cmu-spacecraft-design-build-fly-2023/Avionics-PyCubed-hardware/mainboard-v05/Avionics.kicad_sch

## KiCad design mainboard-v05/Avionics.kicad_sch (2023-09-07)

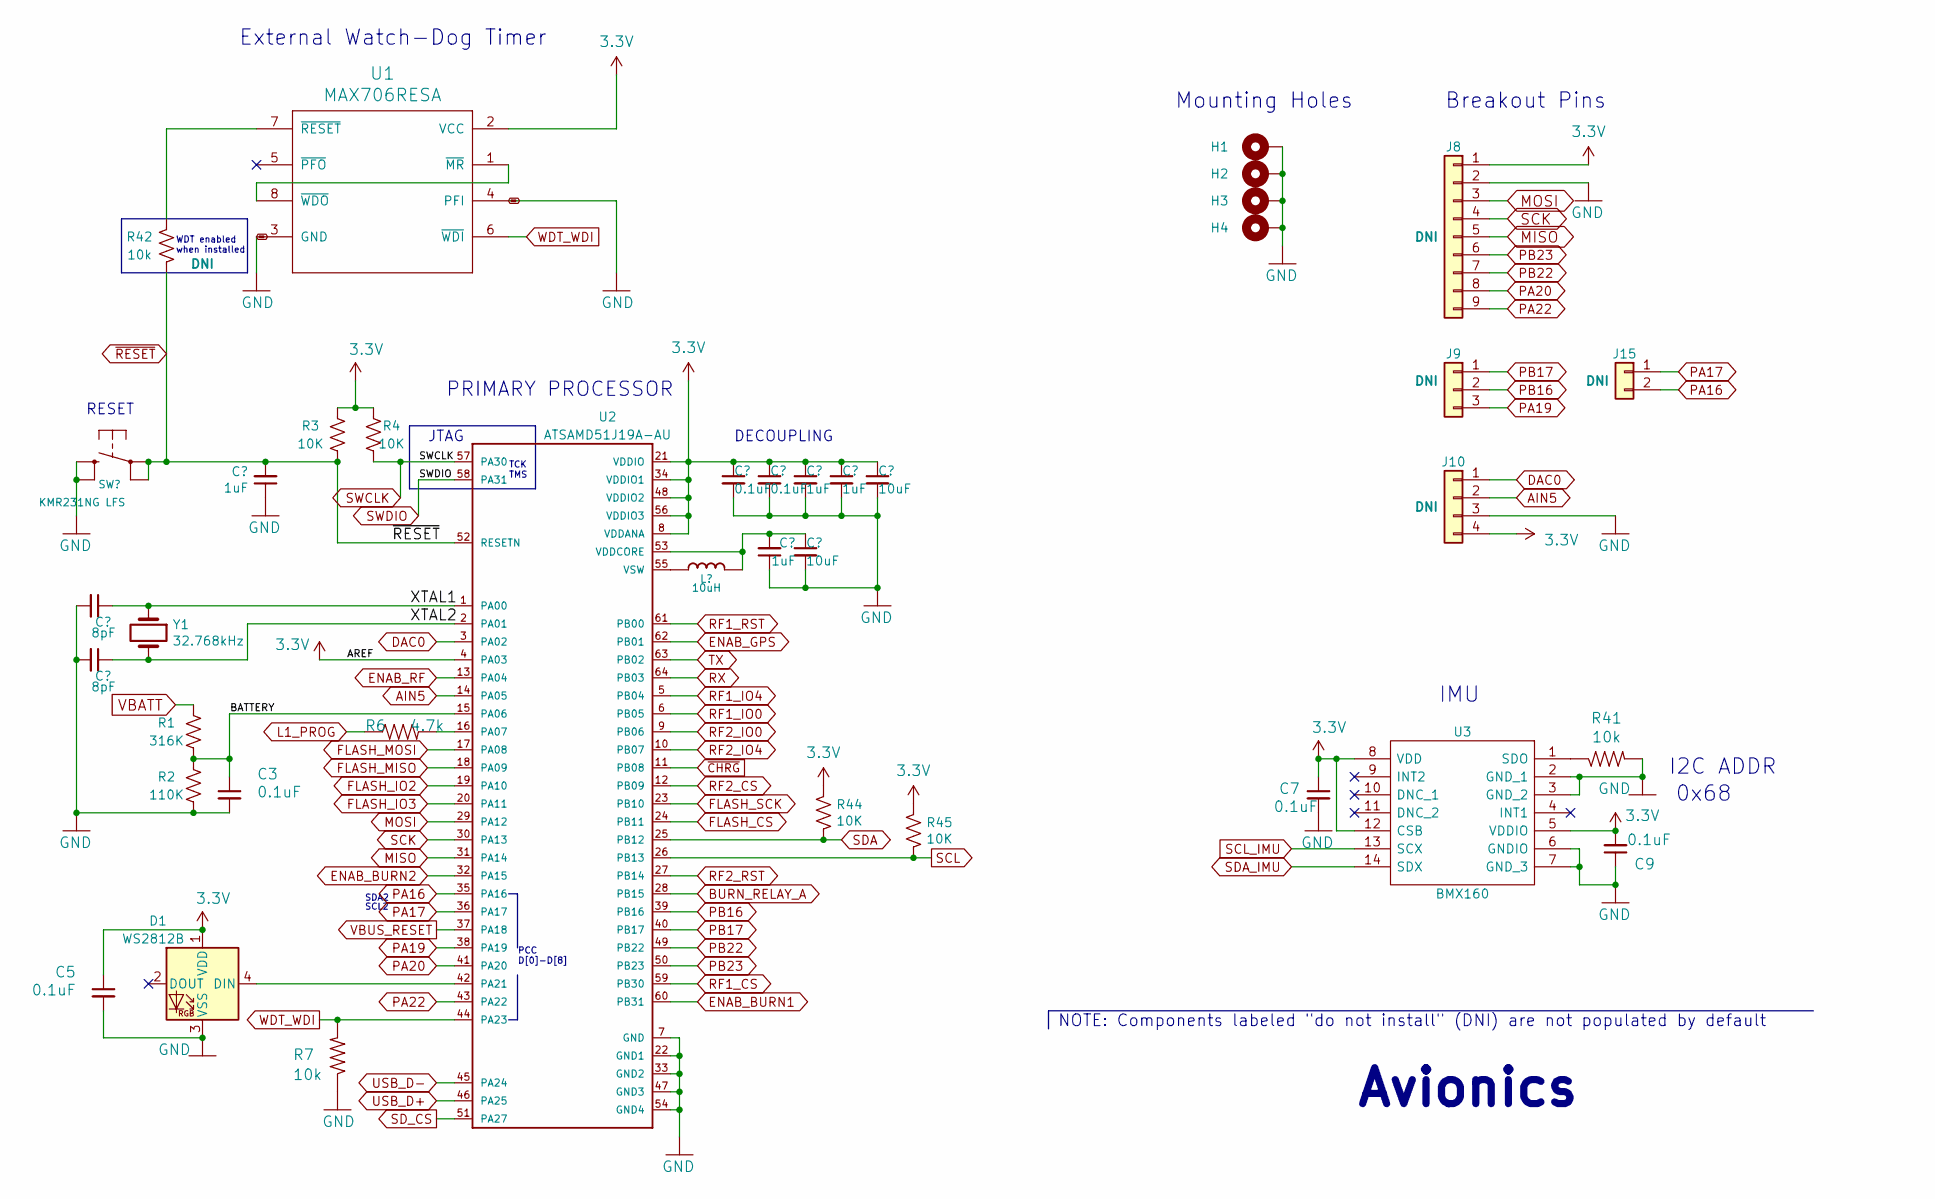
[picture p1: schematic Avionics.kicad_sch]

Parts:
C1, C2: 8pF; C_0603_1608Metric
C3, C5, C7, C9, C10, C11: 0.1uF; C_0603_1608Metric
C4, C12, C13, C15: 1uF; C_0603_1608Metric
C14, C16: 10uF; C_0603_1608Metric
D1: WS2812B; LED_WS2812B_PLCC4_5.0x5.0mm_P3.2mm; Manufacturer_Part_Number WS2812B-B
H1, H2, H3, H4: MountingHole_Pad; MountingHole_3.2mm_M3_DIN965_Pad
J8: Conn_01x09; PinHeader_1x09_P2.54mm_Vertical
J9: Conn_01x03; PinHeader_1x03_P2.54mm_Vertical
J10: Conn_01x04; PinHeader_1x04_P2.54mm_Vertical
J15: Conn_01x02; PinHeader_CUSTOM3
L1: 10uH; L_0805_2012Metric_Pad1.15x1.40mm_HandSolder; Manufacturer_Part_Number MGFL2012F100MT-LF
R1: 316K; R_0603_1608Metric
R2: 110K; R_0603_1608Metric
R3, R4, R44, R45: 10K; R_0603_1608Metric
R6: 4.7k; R_0603_1608Metric
R7, R41, R42: 10k; R_0603_1608Metric
SW1: KMR231NG LFS; BTN_KMR2_4.6X2.8; Manufacturer_Part_Number KMR231NG LFS
U1: MAX706RESA; SO-8_3.9x4.9mm_P1.27mm; Manufacturer_Part_Number MAX706RESA
U2: ATSAMD51J19A-AU; QFP50P1200X1200X120-64N; Manufacturer_Part_Number ATSAMD51J19A-AU
U3: BMX160; Manufacturer_Part_Number BMX160
Y1: 32.768kHz; Crystal_SMD_3215-2Pin_3.2x1.5mm; Manufacturer_Part_Number SC-32S32.768kHz20PPM7pF

Connections:
3.3V: C5.1, C7.1, C9.2, C10.1, C11.1, C13.1, C15.1, C16.1, D1.1 (VDD), J8.1, J10.4, R3.1, R4.1, R44.1, R45.1, U1.2 (VCC), U2.4 (PA03), U2.8 (VDDANA), U2.21 (VDDIO), U2.34 (VDDIO1), U2.48 (VDDIO2), U2.56 (VDDIO3), U3.5 (VDDIO), U3.8 (VDD), U3.12 (CSB)
AIN5: J10.2, U2.14 (PA05)
BATTERY: C3.1, R1.2, R2.2, U2.15 (PA06)
BURN_RELAY_A: U2.28 (PB15)
DAC0: J10.1, U2.3 (PA02)
ENAB_BURN1: U2.60 (PB31)
ENAB_BURN2: U2.32 (PA15)
ENAB_GPS: U2.62 (PB01)
ENAB_RF: U2.13 (PA04)
FLASH_CS: U2.24 (PB11)
FLASH_IO2: U2.19 (PA10)
FLASH_IO3: U2.20 (PA11)
FLASH_MISO: U2.18 (PA09)
FLASH_MOSI: U2.17 (PA08)
FLASH_SCK: U2.23 (PB10)
GND: C1.2, C2.2, C3.2, C4.1, C5.2, C7.2, C9.1, C10.2, C11.2, C12.1, C13.2, C14.2, C15.2, C16.2, D1.3 (VSS), H1.1, H2.1, H3.1, H4.1, J8.2, J10.3, R2.1, R7.1, R41.2, SW1.B (S), SW1.B' (S1), U1.3 (GND), U1.4 (PFI), U2.7 (GND), U2.22 (GND1), U2.33 (GND2), U2.47 (GND3), U2.54 (GND4), U3.2 (GND_1), U3.3 (GND_2), U3.6 (GNDIO), U3.7 (GND_3)
L1_PROG: R6.1
MISO: J8.5, U2.31 (PA14)
MOSI: J8.3, U2.29 (PA12)
unnamed: C12.2, C14.1, L1.1, U2.53 (VDDCORE)
unnamed: D1.4 (DIN), U2.42 (PA21)
unnamed: L1.2, U2.55 (VSW)
unnamed: R6.2, U2.16 (PA07)
unnamed: R41.1, U3.1 (SDO)
unnamed: R42.2, U1.7 (~RESET)
unnamed: U1.1 (~MR), U1.8 (~WDO)
PA16: J15.2, U2.35 (PA16)
PA17: J15.1, U2.36 (PA17)
PA19: J9.3, U2.38 (PA19)
PA20: J8.8, U2.41 (PA20)
PA22: J8.9, U2.43 (PA22)
PB16: J9.2, U2.39 (PB16)
PB17: J9.1, U2.40 (PB17)
PB22: J8.7, U2.49 (PB22)
PB23: J8.6, U2.50 (PB23)
RF1_CS: U2.59 (PB30)
RF1_IO0: U2.6 (PB05)
RF1_IO4: U2.5 (PB04)
RF1_RST: U2.61 (PB00)
RF2_CS: U2.12 (PB09)
RF2_IO0: U2.9 (PB06)
RF2_IO4: U2.10 (PB07)
RF2_RST: U2.27 (PB14)
RX: U2.64 (PB03)
SCK: J8.4, U2.30 (PA13)
SCL: R45.2, U2.26 (PB13)
SCL_IMU: U3.13 (SCX)
SDA: R44.2, U2.25 (PB12)
SDA_IMU: U3.14 (SDX)
SD_CS: U2.51 (PA27)
SWCLK: R4.2, U2.57 (PA30)
SWDIO: U2.58 (PA31)
TX: U2.63 (PB02)
USB_D+: U2.46 (PA25)
USB_D-: U2.45 (PA24)
VBATT: R1.1
VBUS_RESET: U2.37 (PA18)
WDT_WDI: R7.2, U1.6 (~WDI), U2.44 (PA23)
XTAL1: C1.1, U2.1 (PA00), Y1.1
XTAL2: C2.1, U2.2 (PA01), Y1.2
~CHRG: U2.11 (PB08)
~RESET: C4.2, R3.2, R42.1, SW1.A, SW1.A' (P1), U2.52 (RESETN)

Notes on the sheet:
Mounting Holes
PRIMARY PROCESSOR
PCC D[0]-D[8]
TCK TMS
SDA2
DECOUPLING
SCL2
Breakout Pins
IMU
RESET
0x68
WDT enabled when installed
Avionics
External Watch-Dog Timer
I2C ADDR
NOTE: Components labeled "do not install" (DNI) are not populated by default
JTAG
