cmu-spacecraft-design-build-fly-2023/Avionics-PyCubed-hardware/mainboard-v05/Burn_Wires.kicad_sch

## KiCad design mainboard-v05/Burn_Wires.kicad_sch (2023-09-07)

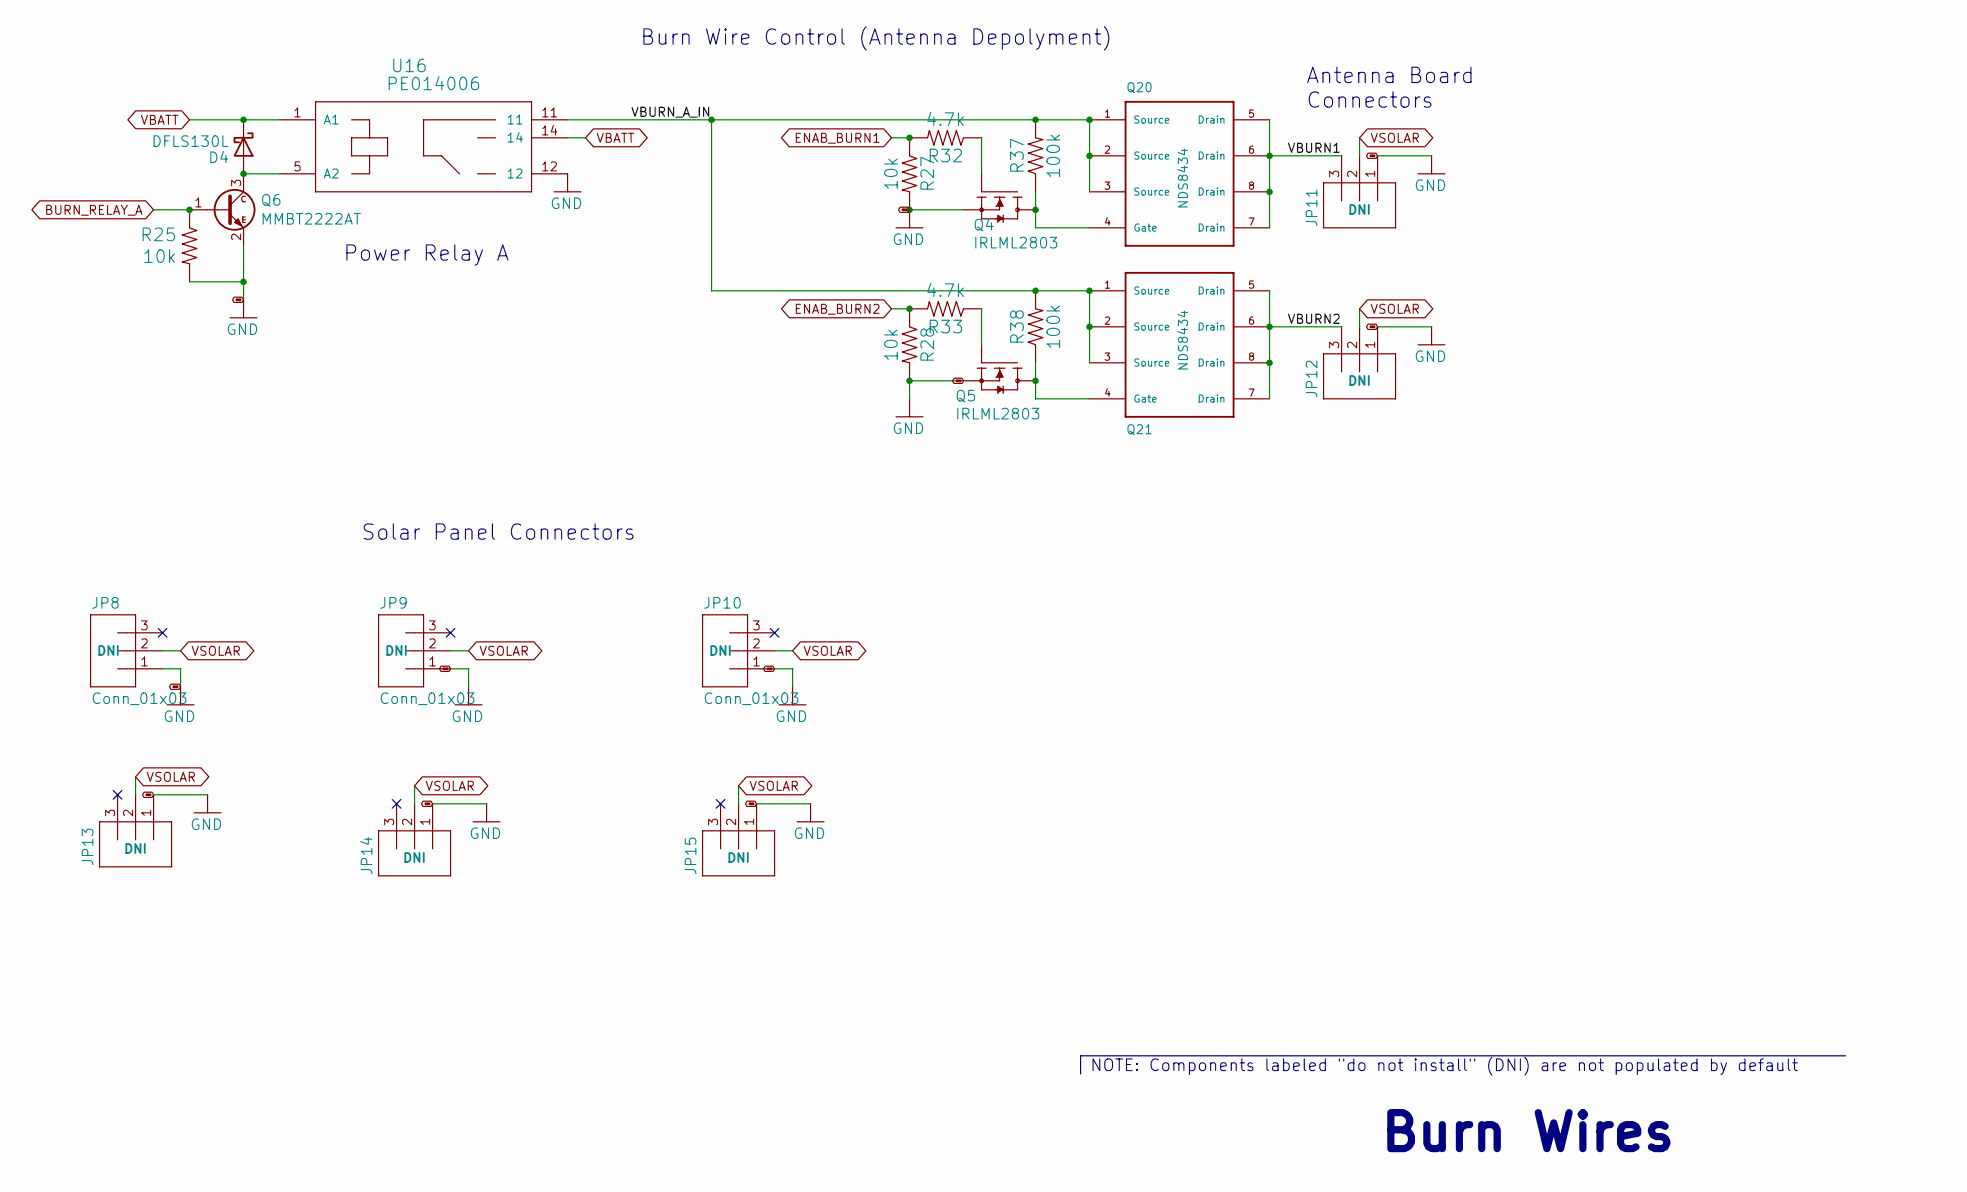
[picture p2: schematic Burn_Wires.kicad_sch]

Parts:
D4: DFLS130L; D_PowerDI-123; Manufacturer_Part_Number DFLS130L-7
JP8, JP9, JP10, JP11, JP12, JP13, JP14, JP15: Conn_01x03; MOLEX-1X3_LOCK; Manufacturer_Part_Number 22-23-2037
Q4: IRLML2803; SOT-23; Manufacturer_Part_Number IRLML2803TRPbF
Q5: IRLML2803; SOT-23; Manufacturer_Part_Number MMBT2222AT
Q6: MMBT2222AT; SOT-23; Manufacturer_Part_Number MMBT2222ALT1G
Q20, Q21: NDS8434; Manufacturer_Part_Number NDS8434
R25, R27, R28: 10k; R_0603_1608Metric
R32, R33: 4.7k; R_0603_1608Metric
R37, R38: 100k; R_0603_1608Metric
U16: PE014006; RELAY_PE014006; Manufacturer_Part_Number PE014006 TE

Connections:
BURN_RELAY_A: Q6.1 (B), R25.1
ENAB_BURN1: R27.1, R32.2
ENAB_BURN2: R28.1, R33.2
GND: JP8.1, JP9.1, JP10.1, JP11.1, JP12.1, JP13.1, JP14.1, JP15.1, Q4.2 (S), Q5.2 (S), Q6.2 (E), R25.2, R27.2, R28.2, U16.12
unnamed: D4.2 (A), Q6.3 (C), U16.5 (A2)
unnamed: Q4.1 (G), R32.1
unnamed: Q5.1 (G), R33.1
unnamed: Q4.3 (D), Q20.4 (Gate), R37.1
unnamed: Q5.3 (D), Q21.4 (Gate), R38.1
VBATT: D4.1 (K), U16.1 (A1), U16.14
VBURN1: JP11.3, Q20.5 (Drain), Q20.6 (Drain), Q20.7 (Drain), Q20.8 (Drain)
VBURN2: JP12.3, Q21.5 (Drain), Q21.6 (Drain), Q21.7 (Drain), Q21.8 (Drain)
VBURN_A_IN: Q20.1 (Source), Q20.2 (Source), Q20.3 (Source), Q21.1 (Source), Q21.2 (Source), Q21.3 (Source), R37.2, R38.2, U16.11
VSOLAR: JP8.2, JP9.2, JP10.2, JP11.2, JP12.2, JP13.2, JP14.2, JP15.2

Notes on the sheet:
Burn Wires
Solar Panel Connectors
Antenna Board Connectors
NOTE: Components labeled "do not install" (DNI) are not populated by default
Burn Wire Control (Antenna Depolyment)
Power Relay A
