cmu-spacecraft-design-build-fly-2023/Avionics-PyCubed-hardware/mainboard-v05/Connectors.kicad_sch

## KiCad design mainboard-v05/Connectors.kicad_sch (2023-09-07)

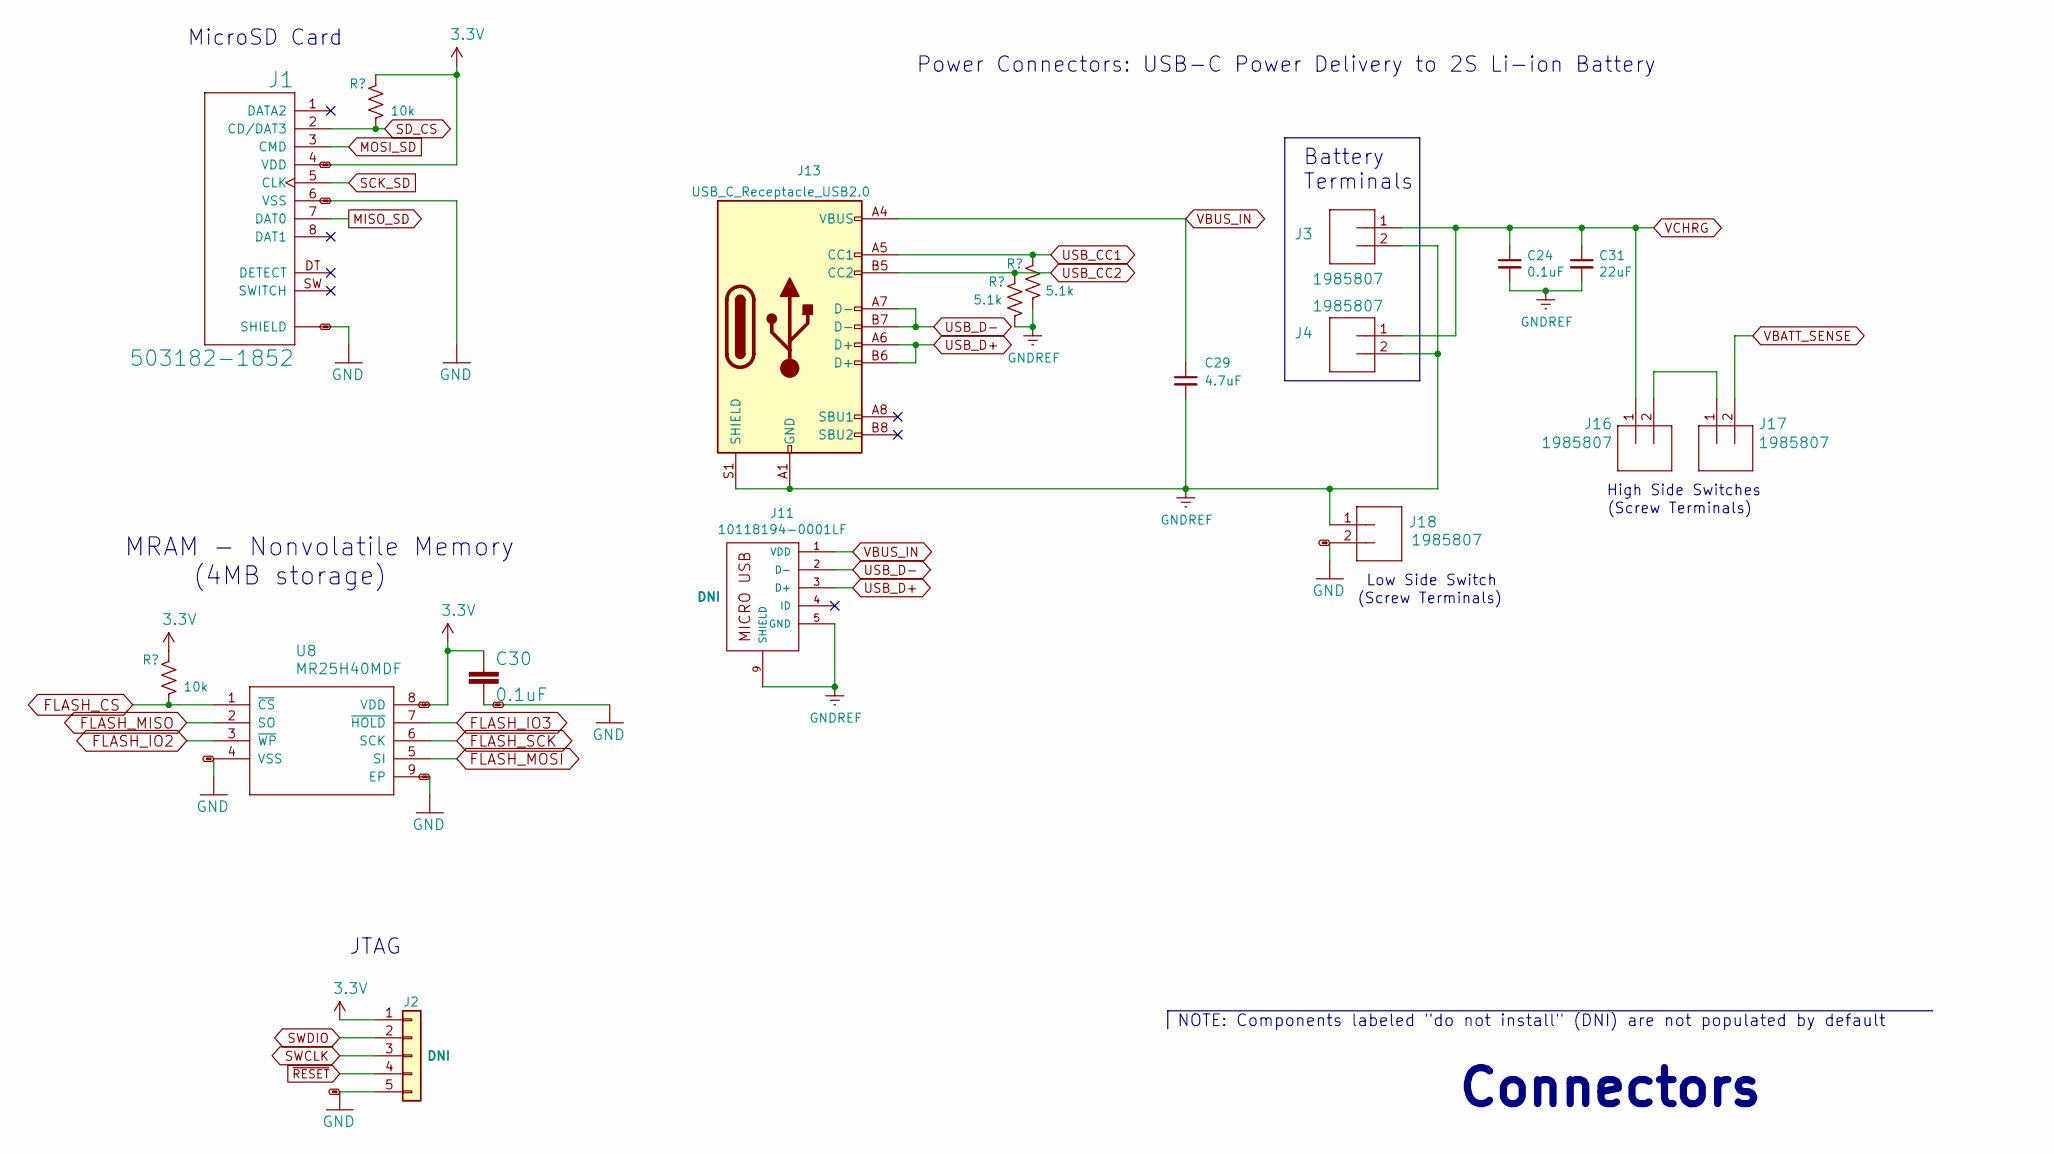
[picture p4: schematic Connectors.kicad_sch]

Parts:
C24, C30: 0.1uF; C_0603_1608Metric
C29: 4.7uF; C_0603_1608Metric
C31: 22uF; C_0603_1608Metric
J1: 503182-1852; MOLEX_503182-1852; Manufacturer_Part_Number 5031821852
J2: Conn_01x05; PinHeader_1x05_P2.54mm_Vertical
J3, J4, J16, J17, J18: 1985807; SCREWTERMINAL-3.5MM-2_LOCK; Manufacturer_Part_Number 1985807
J11: 10118194-0001LF; AMPHENOL_10118194-0001LF
J13: USB_C_Receptacle_USB2.0; USB_C_Receptacle_GCT_USB4105-xx-A_16P_TopMnt_Horizontal; Manufacturer_Part_Number U262-161N-4BVC11
R39, R40: 5.1k; R_0603_1608Metric
R50, R51: 10k; R_0603_1608Metric
U8: MR25H40MDF; SON127P600X500X90-9N; Manufacturer_Part_Number W25Q80DVSNIG

Connections:
3.3V: C30.1, J1.4 (VDD), J2.1, R50.2, R51.2, U8.8 (VDD)
FLASH_CS: R50.1, U8.1 (~CS)
FLASH_IO2: U8.3 (~WP)
FLASH_IO3: U8.7 (~HOLD)
FLASH_MISO: U8.2 (SO)
FLASH_MOSI: U8.5 (SI)
FLASH_SCK: U8.6 (SCK)
GND: C30.2, J1.6 (VSS), J1.P1 (SHIELD), J1.P2 (SHIELD), J1.P3 (SHIELD), J1.P4 (SHIELD), J1.P5 (SHIELD), J2.5, J18.2, U8.4 (VSS), U8.9 (EP)
GNDREF: C24.2, C29.2, C31.2, J3.2, J4.2, J11.5 (GND), J11.8, J11.9 (SHIELD), J13.A1 (GND), J13.A12 (GND), J13.B1 (GND), J13.B12 (GND), J13.S1 (SHIELD), J18.1, R39.1, R40.1
MISO_SD: J1.7 (DAT0)
MOSI_SD: J1.3 (CMD)
unnamed: J16.2, J17.1
SCK_SD: J1.5 (CLK)
SD_CS: J1.2 (CD/DAT3), R51.1
SWCLK: J2.3
SWDIO: J2.2
USB_CC1: J13.A5 (CC1), R40.2
USB_CC2: J13.B5 (CC2), R39.2
USB_D+: J11.3 (D+), J13.A6 (D+), J13.B6 (D+)
USB_D-: J11.2 (D-), J13.A7 (D-), J13.B7 (D-)
VBATT_SENSE: J17.2
VBUS_IN: C29.1, J11.1 (VDD), J13.A4 (VBUS), J13.A9 (VBUS), J13.B4 (VBUS), J13.B9 (VBUS)
VCHRG: C24.1, C31.1, J3.1, J4.1, J16.1
~RESET: J2.4

Notes on the sheet:
JTAG
(Screw Terminals)
Connectors
MRAM - Nonvolatile Memory (4MB storage)
MicroSD Card
NOTE: Components labeled "do not install" (DNI) are not populated by default
Battery Terminals
Power Connectors: USB-C Power Delivery to 2S Li-ion Battery
High Side Switches
Low Side Switch
