cmu-spacecraft-design-build-fly-2023/Avionics-PyCubed-hardware/mainboard-v05/Power.kicad_sch

## KiCad design mainboard-v05/Power.kicad_sch (2023-09-07)

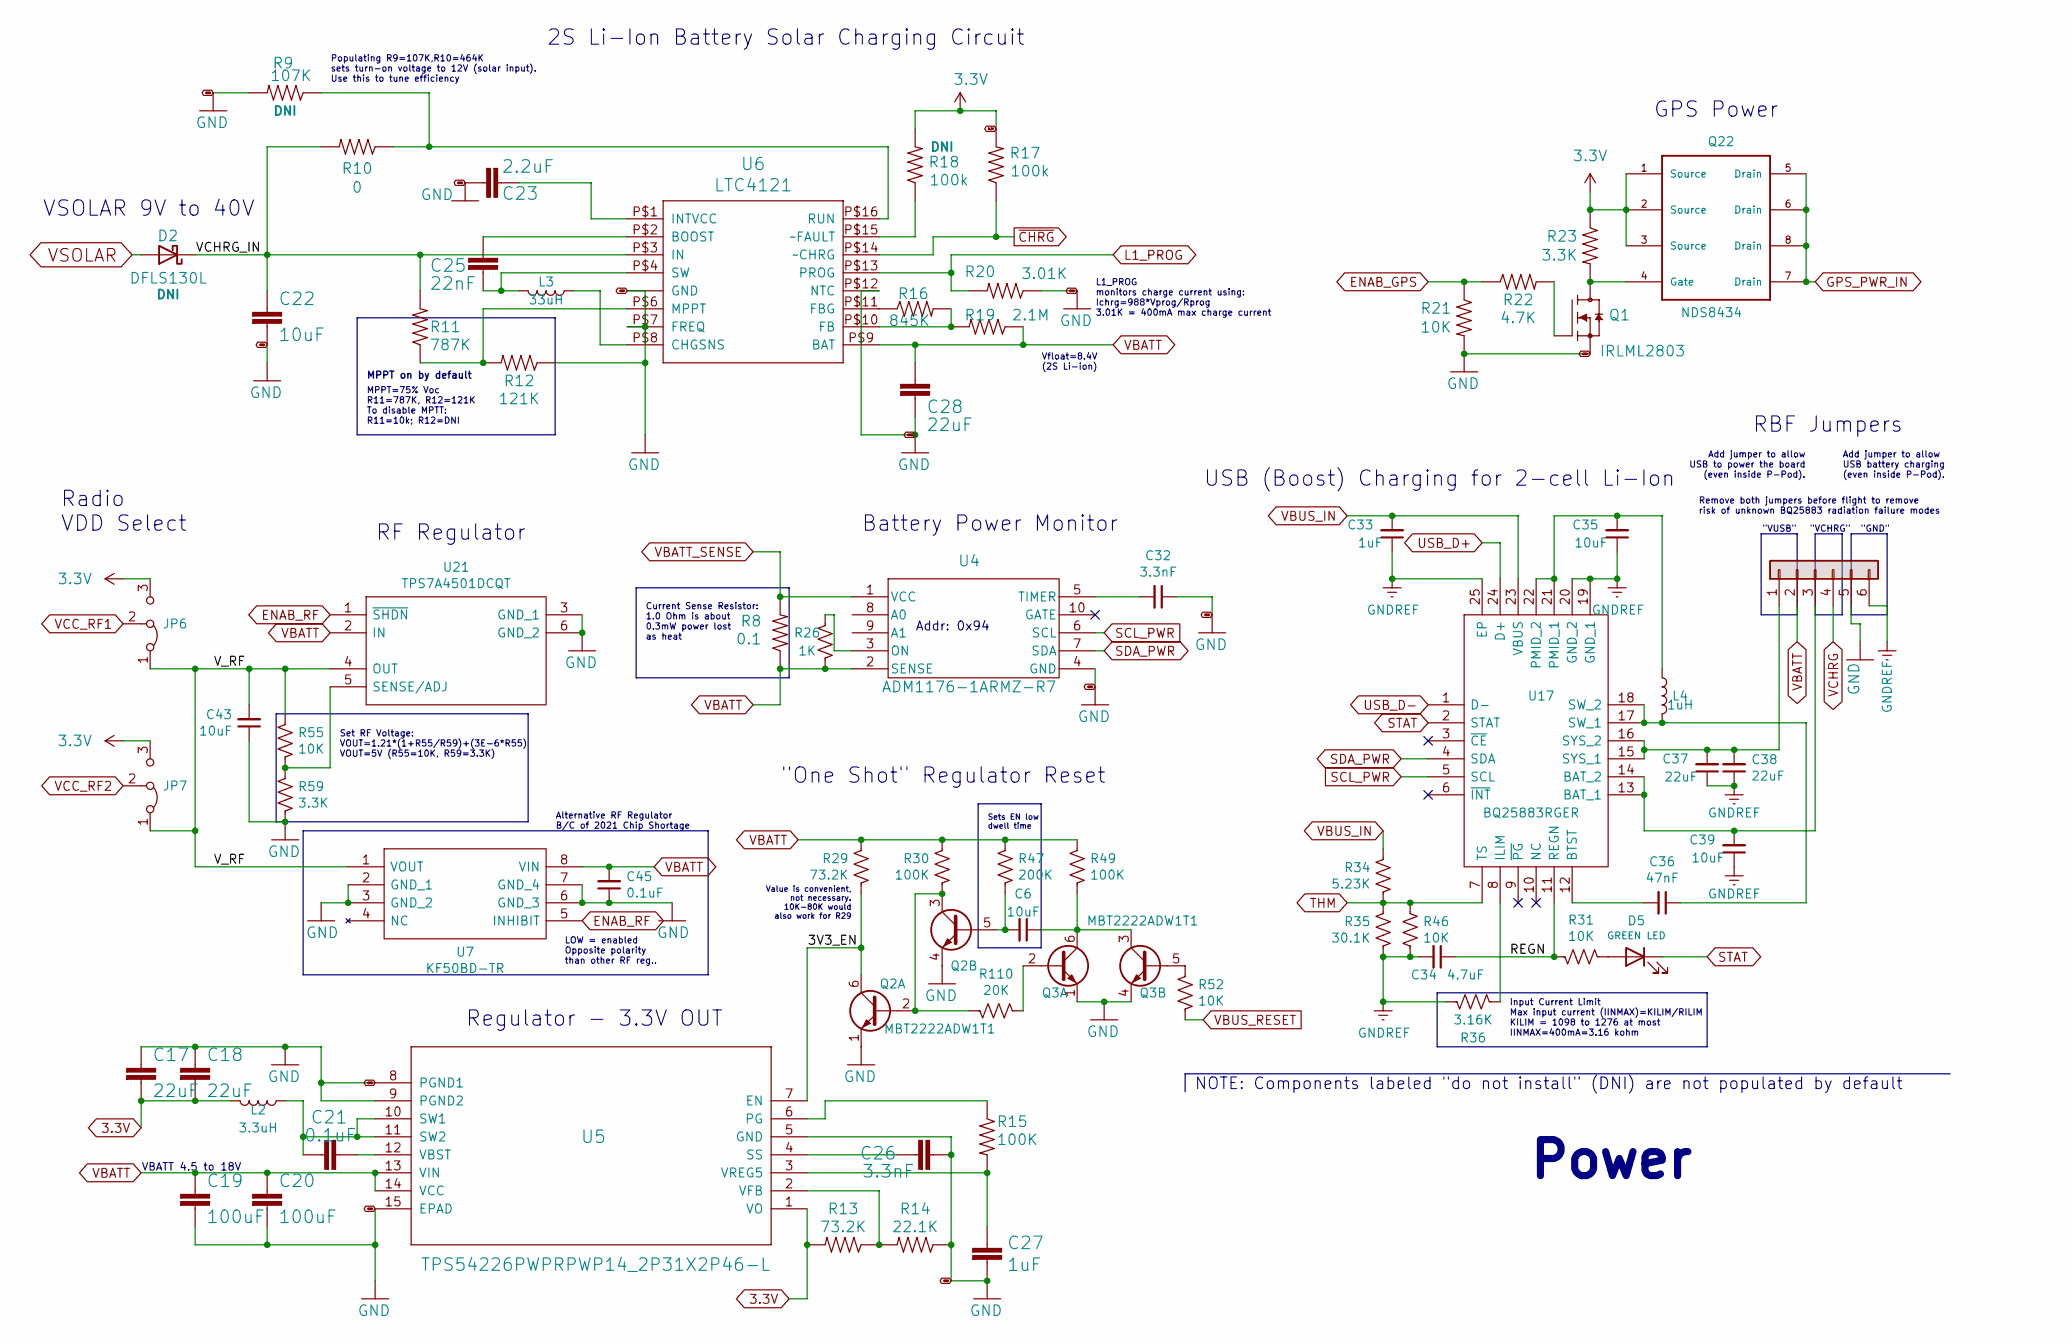
[picture p5: schematic Power.kicad_sch]

Parts:
C6, C22, C35, C39, C43: 10uF; C_0603_1608Metric
C17, C18, C28, C37, C38: 22uF; C_0603_1608Metric
C19, C20: 100uF; C_1210_3225Metric
C21, C45: 0.1uF; C_0603_1608Metric
C23: 2.2uF; C_0603_1608Metric
C25: 22nF; C_0603_1608Metric
C26, C32: 3.3nF; C_0603_1608Metric
C27, C33: 1uF; C_0603_1608Metric
C34: 4.7uF; C_0603_1608Metric
C36: 47nF; C_0603_1608Metric
D2: DFLS130L; D_PowerDI-123; Manufacturer_Part_Number DFLS130L-7
D5: GREEN LED; LED_0603_1608Metric; Manufacturer_Part_Number LTST-C190KGKT
J14: Conn_01x06; PinHeader_1x06_P2.54mm_Vertical
JP6, JP7: Jumper_3_Bridged12; SolderJumper-3_P1.3mm_Bridged12_RoundedPad1.0x1.5mm
L2: 3.3uH; L_2141; Manufacturer_Part_Number HPC5040NF-3R3MTH
L3: 33uH; L_1812_4532Metric; Manufacturer_Part_Number SNR5040K-330M
L4: 1uH; L_2510; Manufacturer_Part_Number MCS25GD-1R0MMP
Q1: IRLML2803; SOT-23; Manufacturer_Part_Number IRLML2803TRPbF
Q2, Q3: MBT2222ADW1T1; SOT-363_SC-70-6; Manufacturer_Part_Number MBT2222ADW1T1G
Q22: NDS8434; Manufacturer_Part_Number NDS8434
R8: 0.1; R_2512_6332Metric
R9: 107K; R_0603_1608Metric
R10: 0; R_0603_1608Metric
R11: 787K; R_0603_1608Metric
R12: 121K; R_0603_1608Metric
R13, R29: 73.2K; R_0603_1608Metric
R14: 22.1K; R_0603_1608Metric
R15, R30, R49: 100K; R_0603_1608Metric
R16: 845K; R_0603_1608Metric
R17, R18: 100k; R_0603_1608Metric
R19: 2.1M; R_0603_1608Metric
R20: 3.01K; R_0603_1608Metric
R21, R31, R46, R52, R55: 10K; R_0603_1608Metric
R22: 4.7K; R_0603_1608Metric
R23, R59: 3.3K; R_0603_1608Metric
R26: 1K; R_0603_1608Metric
R34: 5.23K; R_0603_1608Metric
R35: 30.1K; R_0603_1608Metric
R36: 3.16K; R_0603_1608Metric
R47: 200K; R_0603_1608Metric
R110: 20K; R_0603_1608Metric
U4: ADM1176-1ARMZ-R7; Manufacturer_Part_Number ADM1176-1ARMZ-R7
U5: TPS54226PWPRPWP14_2P31X2P46-L; PWP14_2P31X2P46-L; Manufacturer_Part_Number TPS54226PWPR
U6: LTC4121; QFN-16-PAD; Manufacturer_Part_Number LTC4121EUD
U7: KF50BD-TR; SOIC127P600X175-8N; Manufacturer_Part_Number KF50BD-TR
U17: BQ25883RGER; QFN50P400X400X100-25N-D; Manufacturer_Part_Number BQ25883RGER
U21: TPS7A4501DCQT; Manufacturer_Part_Number TPS7A4501DCQT

Connections:
3.3V: C17.2, C18.2, JP6.3 (B), JP7.3 (B), L2.2, Q22.1 (Source), Q22.2 (Source), Q22.3 (Source), R13.2, R17.2, R18.2, R23.1, U5.1 (VO)
3V3_EN: Q2.6 (C1), R29.2, U5.7 (EN)
ENAB_GPS: R21.1, R22.1
ENAB_RF: U7.5 (INHIBIT), U21.1 (~SHDN)
GND: C17.1, C18.1, C19.2, C20.2, C22.2, C23.2, C26.2, C27.2, C28.2, C32.1, C43.1, C45.1, J14.5, Q1.2 (S), Q2.1 (E1), Q2.4 (E2), Q3.1 (E1), Q3.4 (E2), R9.2, R12.1, R14.1, R20.1, R21.2, R59.2, U4.4 (GND), U5.5 (GND), U5.8 (PGND1), U5.9 (PGND2), U5.15 (EPAD), U6.P$5 (GND), U6.P$7 (FREQ), U6.P$12 (NTC), U6.P$17 (GND), U7.2 (GND_1), U7.3 (GND_2), U7.6 (GND_3), U7.7 (GND_4), U21.3 (GND_1), U21.6 (GND_2)
GNDREF: C33.1, C34.2, C35.1, C37.1, C38.1, C39.1, J14.6, R35.1, R36.1, R46.1, U17.19 (GND_1), U17.20 (GND_2), U17.25 (EP)
GPS_PWR_IN: Q22.5 (Drain), Q22.6 (Drain), Q22.7 (Drain), Q22.8 (Drain)
L1_PROG: R20.2, U6.P$13 (PROG)
unnamed: C6.1, Q3.3 (C2), Q3.6 (C1), R49.2
unnamed: C6.2, Q2.5 (B2), R47.2
unnamed: C21.1, L2.1, U5.10 (SW1), U5.11 (SW2)
unnamed: C21.2, U5.12 (VBST)
unnamed: C23.1, U6.P$1 (INTVCC)
unnamed: C25.1, U6.P$2 (BOOST)
unnamed: C25.2, L3.2, U6.P$4 (SW)
unnamed: C26.1, U5.4 (SS)
unnamed: C27.1, R15.2, U5.3 (VREG5)
unnamed: C32.2, U4.5 (TIMER)
unnamed: C35.2, L4.1, U17.21 (PMID_1), U17.22 (PMID_2)
unnamed: C36.1, L4.2, U17.17 (SW_1), U17.18 (SW_2)
unnamed: C36.2, U17.12 (BTST)
unnamed: C37.2, C38.2, J14.1, U17.15 (SYS_1), U17.16 (SYS_2)
unnamed: C39.2, J14.3, U17.13 (BAT_1), U17.14 (BAT_2)
unnamed: D5.2 (A), R31.1
unnamed: L3.1, U6.P$8 (CHGSNS)
unnamed: Q1.1 (G), R22.2
unnamed: Q1.3 (D), Q22.4 (Gate), R23.2
unnamed: Q2.2 (B1), Q2.3 (C2), R30.2, R110.2
unnamed: Q3.2 (B1), R110.1
unnamed: Q3.5 (B2), R52.1
unnamed: R9.1, R10.1, U6.P$16 (RUN)
unnamed: R11.1, R12.2, U6.P$6 (MPPT)
unnamed: R13.1, R14.2, U5.2 (VFB)
unnamed: R15.1, U5.6 (PG)
unnamed: R16.1, U6.P$11 (FBG)
unnamed: R16.2, R19.2, U6.P$10 (FB)
unnamed: R18.1, U6.P$15 (~FAULT)
unnamed: R26.2, U4.3 (ON)
unnamed: R36.2, U17.8 (ILIM)
unnamed: R55.2, R59.1, U21.5 (SENSE/ADJ)
REGN: C34.1, R31.2, U17.11 (REGN)
SCL_PWR: U4.6 (SCL), U17.5 (SCL)
SDA_PWR: U4.7 (SDA), U17.4 (SDA)
STAT: D5.1 (K), U17.2 (STAT)
THM: R34.2, R35.2, R46.2, U17.7 (TS)
USB_D+: U17.24 (D+)
USB_D-: U17.1 (D-)
VBATT: C19.1, C20.1, C28.1, C45.2, J14.2, R8.1, R19.1, R26.1, R29.1, R30.1, R47.1, R49.1, U4.2 (SENSE), U5.13 (VIN), U5.14 (VCC), U6.P$9 (BAT), U7.8 (VIN), U21.2 (IN)
VBATT_SENSE: R8.2, U4.1 (VCC)
VBUS_IN: C33.2, R34.1, U17.23 (VBUS)
VBUS_RESET: R52.2
VCC_RF1: JP6.2 (C)
VCC_RF2: JP7.2 (C)
VCHRG: J14.4
VCHRG_IN: C22.1, D2.1 (K), R10.2, R11.2, U6.P$3 (IN)
VSOLAR: D2.2 (A)
V_RF: C43.2, JP6.1 (A), JP7.1 (A), R55.1, U7.1 (VOUT), U21.4 (OUT)
~CHRG: R17.1, U6.P$14 (~CHRG)

Notes on the sheet:
"One Shot" Regulator Reset
Regulator - 3.3V OUT
GPS Power
L1_PROG monitors charge current using: Ichrg=988*Vprog/Rprog 3.01K = 400mA max charge current
Battery Power Monitor
Addr: 0x94
Radio VDD Select
"VUSB"
RBF Jumpers
Add jumper to allow USB to power the board (even inside P-Pod).
RF Regulator
MPPT on by default
Set RF Voltage: VOUT=1.21*(1+R55/R59)+(3E-6*R55) VOUT=5V (R55=10K, R59=3.3K)
Value is convenient, not necessary. 10K-80K would also work for R29
Add jumper to allow USB battery charging (even inside P-Pod).
Vfloat=8.4V (2S Li-ion)
2S Li-Ion Battery Solar Charging Circuit
"GND"
Input Current Limit Max input current (IINMAX)=KILIM/RILIM KILIM = 1098 to 1276 at most IINMAX=400mA=3.16 kohm
NOTE: Components labeled "do not install" (DNI) are not populated by default
Current Sense Resistor: 1.0 Ohm is about 0.3mW power lost as heat
Alternative RF Regulator B/C of 2021 Chip Shortage
USB (Boost) Charging for 2-cell Li-Ion
Sets EN low dwell time
VSOLAR 9V to 40V
VBATT 4.5 to 18V
Remove both jumpers before flight to remove risk of unknown BQ25883 radiation failure modes
Power
"VCHRG"
Populating R9=107K,R10=464K sets turn-on voltage to 12V (solar input). Use this to tune efficiency
LOW = enabled Opposite polarity than other RF reg..
MPPT=75% Voc R11=787K, R12=121K To disable MPTT: R11=10k; R12=DNI
