cmu-spacecraft-design-build-fly-2023/Avionics-PyCubed-hardware/mainboard-v05/RF_and_GPS.kicad_sch

## KiCad design mainboard-v05/RF_and_GPS.kicad_sch (2023-09-07)

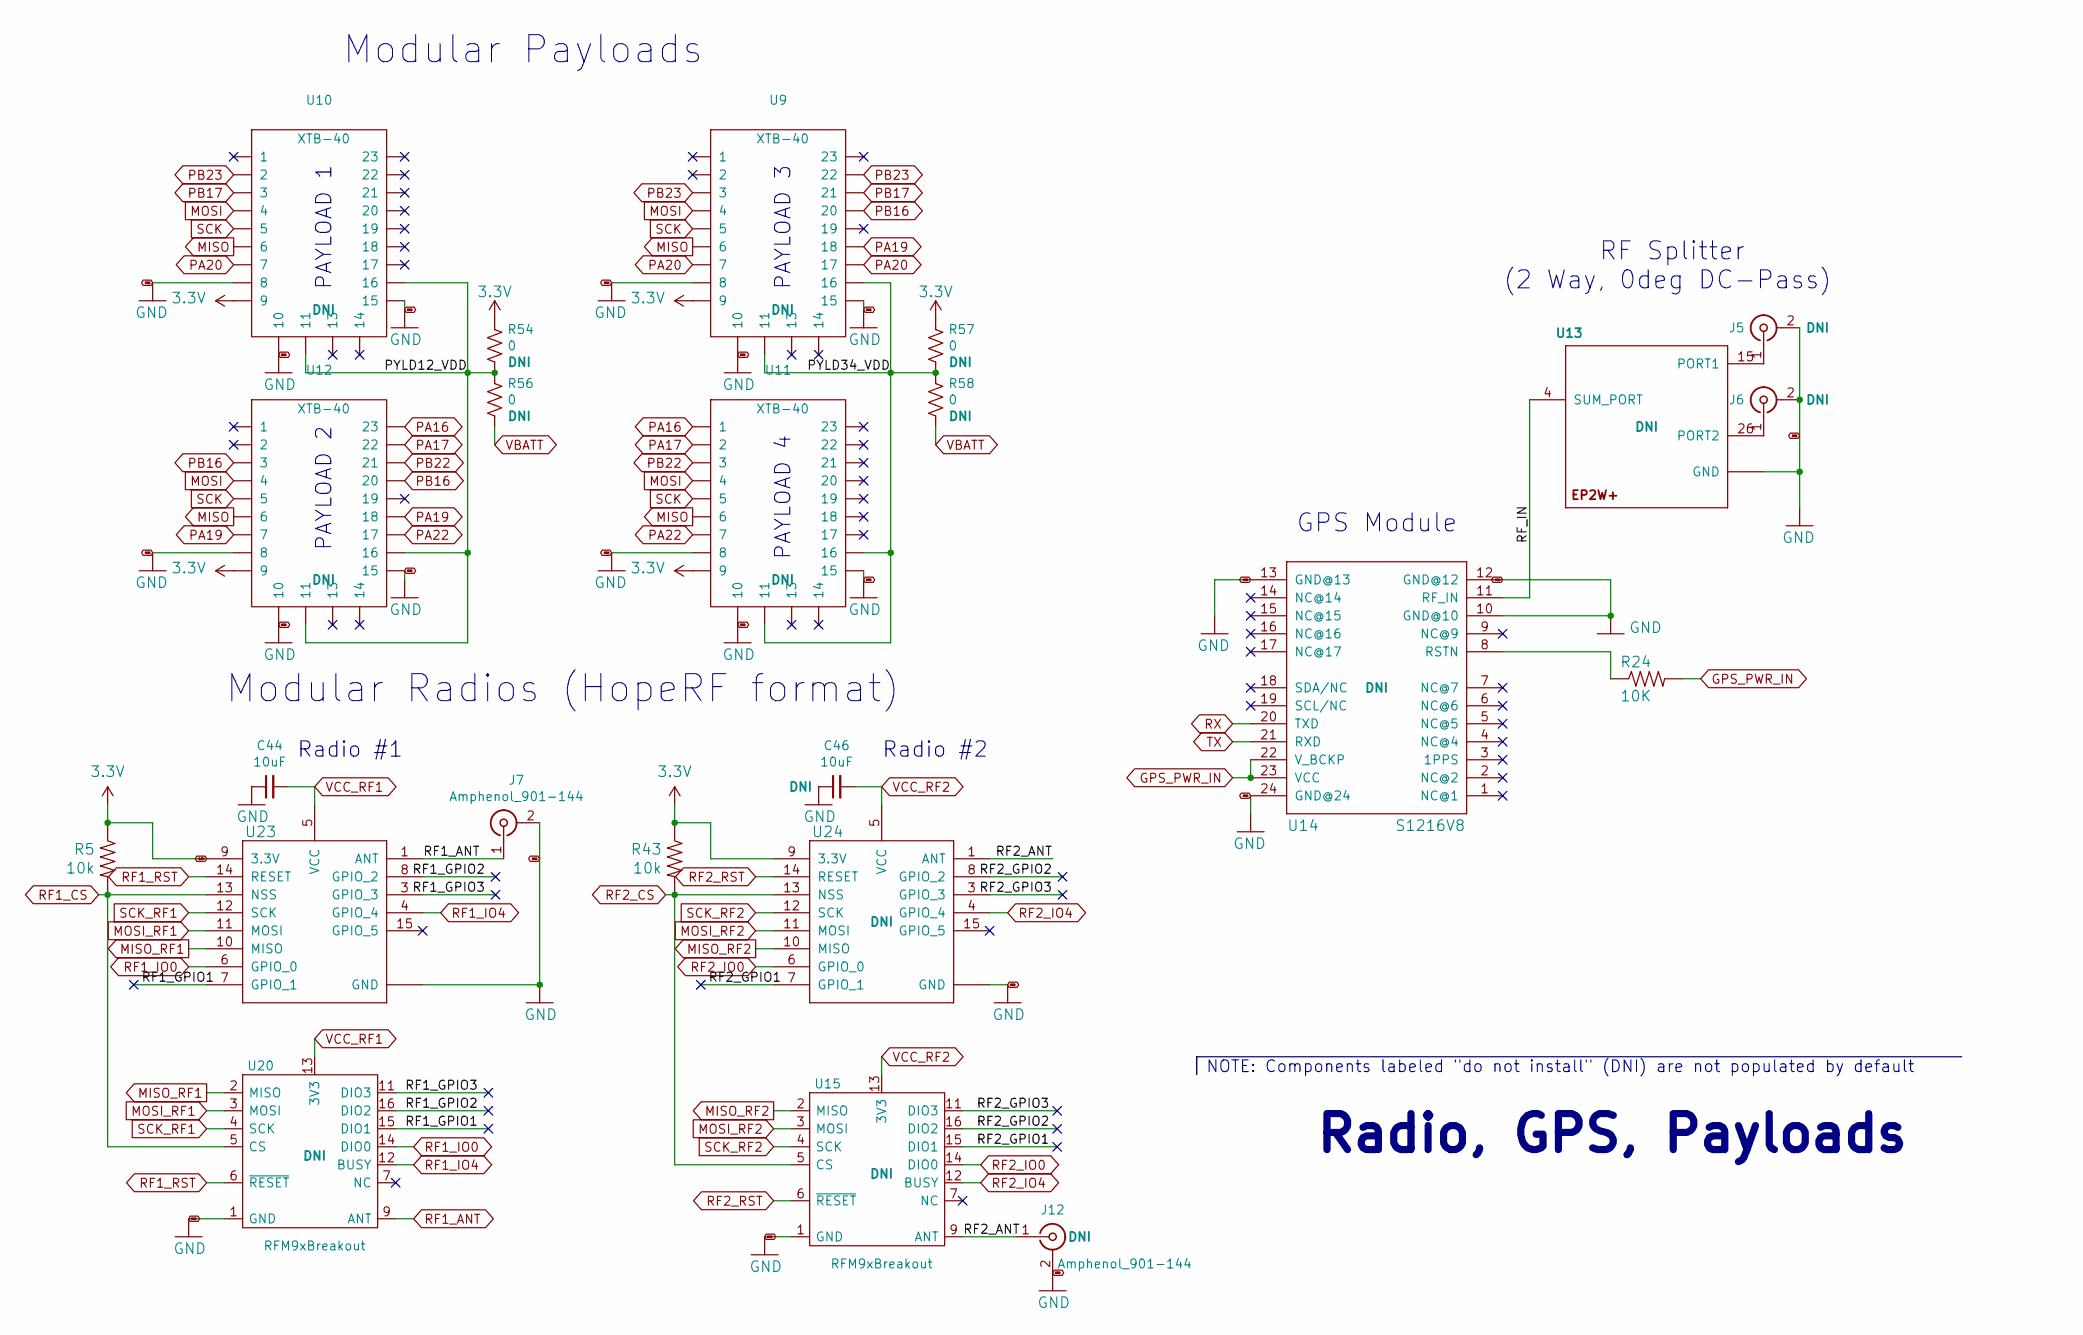
[picture p6: schematic RF_and_GPS.kicad_sch]

Parts:
C44, C46: 10uF; C_0603_1608Metric
J5, J6, J7, J12: Amphenol_901-144; SMA_Amphenol_901-144_Vertical; Manufacturer_Part_Number 901-144
R5, R43: 10k; R_0603_1608Metric
R24: 10K; R_0603_1608Metric
R54, R56, R57, R58: 0; R_0805_2012Metric
U9, U10, U11, U12: XTB-40; XTB40_payload
U13: EP2W+; QFN32-5X5MM; Manufacturer_Part_Number EP2W+
U14: S1216V8; S1216_24PIN_PACKAGE
U15, U20: RFM9xBreakout; HOPERF_RFM9XW_SMD
U23: RFM98PW; RFM95PW; Manufacturer_Part_Number RFM98PW
U24: RFM98PW; RFM95PW

Connections:
3.3V: R5.1, R43.1, R54.1, R57.1, U9.9, U10.9, U11.9, U12.9, U23.9 (3.3V), U24.9 (3.3V)
GND: C44.1, C46.1, J5.2 (Ext), J6.2 (Ext), J7.2 (Ext), J12.2 (Ext), U9.8, U9.10, U9.15, U10.8, U10.10, U10.15, U11.8, U11.10, U11.15, U12.8, U12.10, U12.15, U13.1 (GND), U13.2 (GND), U13.3 (GND), U13.5 (GND), U13.6 (GND), U13.7 (GND), U13.8 (GND), U13.9 (GND), U13.10 (GND), U13.11 (GND), U13.12 (GND), U13.13 (GND), U13.14 (GND), U13.16 (GND), U13.17 (GND), U13.18 (GND), U13.19 (GND), U13.20 (GND), U13.21 (GND), U13.22 (GND), U13.23 (GND), U13.24 (GND), U13.25 (GND), U13.27 (GND), U13.28 (GND), U13.29 (GND), U13.30 (GND), U13.31 (GND), U13.32 (GND), U13.EP (GND), U14.10 (GND@10), U14.12 (GND@12), U14.13 (GND@13), U14.24 (GND@24), U15.1 (GND), U15.8 (GND), U15.10 (GND), U20.1 (GND), U20.8 (GND), U20.10 (GND), U23.2 (GND), U23.16 (GND), U23.17 (GND), U24.2 (GND), U24.16 (GND), U24.17 (GND)
GPS_PWR_IN: R24.2, U14.22 (V_BCKP), U14.23 (VCC)
MISO: U9.6, U10.6, U11.6, U12.6
MISO_RF1: U20.2 (MISO), U23.10 (MISO)
MISO_RF2: U15.2 (MISO), U24.10 (MISO)
MOSI: U9.4, U10.4, U11.4, U12.4
MOSI_RF1: U20.3 (MOSI), U23.11 (MOSI)
MOSI_RF2: U15.3 (MOSI), U24.11 (MOSI)
unnamed: J5.1 (In), U13.15 (PORT1)
unnamed: J6.1 (In), U13.26 (PORT2)
unnamed: R24.1, U14.8 (RSTN)
PA16: U11.1, U12.23
PA17: U11.2, U12.22
PA19: U9.18, U12.7, U12.18
PA20: U9.7, U9.17, U10.7
PA22: U11.7, U12.17
PB16: U9.20, U12.3, U12.20
PB17: U9.21, U10.3
PB22: U11.3, U12.21
PB23: U9.3, U9.22, U10.2
PYLD12_VDD: R54.2, R56.1, U10.11, U10.16, U12.11, U12.16
PYLD34_VDD: R57.2, R58.1, U9.11, U9.16, U11.11, U11.16
RF1_ANT: J7.1 (In), U20.9 (ANT), U23.1 (ANT)
RF1_CS: R5.2, U20.5 (CS), U23.13 (NSS)
RF1_GPIO1: U20.15 (DIO1), U23.7 (GPIO_1)
RF1_GPIO2: U20.16 (DIO2), U23.8 (GPIO_2)
RF1_GPIO3: U20.11 (DIO3), U23.3 (GPIO_3)
RF1_IO0: U20.14 (DIO0), U23.6 (GPIO_0)
RF1_IO4: U20.12 (BUSY), U23.4 (GPIO_4)
RF1_RST: U20.6 (~RESET), U23.14 (RESET)
RF2_ANT: J12.1 (In), U15.9 (ANT), U24.1 (ANT)
RF2_CS: R43.2, U15.5 (CS), U24.13 (NSS)
RF2_GPIO1: U15.15 (DIO1), U24.7 (GPIO_1)
RF2_GPIO2: U15.16 (DIO2), U24.8 (GPIO_2)
RF2_GPIO3: U15.11 (DIO3), U24.3 (GPIO_3)
RF2_IO0: U15.14 (DIO0), U24.6 (GPIO_0)
RF2_IO4: U15.12 (BUSY), U24.4 (GPIO_4)
RF2_RST: U15.6 (~RESET), U24.14 (RESET)
RF_IN: U13.4 (SUM_PORT), U14.11 (RF_IN)
RX: U14.20 (TXD)
SCK: U9.5, U10.5, U11.5, U12.5
SCK_RF1: U20.4 (SCK), U23.12 (SCK)
SCK_RF2: U15.4 (SCK), U24.12 (SCK)
TX: U14.21 (RXD)
VBATT: R56.2, R58.2
VCC_RF1: C44.2, U20.13 (3V3), U23.5 (VCC)
VCC_RF2: C46.2, U15.13 (3V3), U24.5 (VCC)

Notes on the sheet:
PAYLOAD 2
Radio #2
GPS Module
Modular Radios (HopeRF format)
PAYLOAD 4
PAYLOAD 1
PAYLOAD 3
RF Splitter (2 Way, 0deg DC-Pass)
Radio #1
NOTE: Components labeled "do not install" (DNI) are not populated by default
Radio, GPS, Payloads
Modular Payloads
