cmu-spacecraft-design-build-fly-2023/Avionics-PyCubed-hardware/(commit log)

2023-09-07 KiCad V7 updates and cleanup
    [Avionics.kicad_sch, Avionics.sch, Burn_Wires.kicad_sch, Burn_Wires.sch, Bus_Protection.kicad_sch, Bus_Protection.sch, Connectors.kicad_sch, Connectors.sch]
2023-09-07 Bumped schematic version to v05d. Changed parity warning priority
    [Avionics.kicad_sch, Burn_Wires.kicad_sch, Bus_Protection.kicad_sch, Connectors.kicad_sch, Power.kicad_sch, RF_and_GPS.kicad_sch, mainboard.kicad_sch]
